harisharaju1/handheld-robotics-v1/exports/manifest.md

# Export manifest

| Part | Qty | Made by | Bounding box (mm) | Solid PETG (g, each) |
| --- | --- | --- | --- | --- |
| 00_coupon_holes | 1 | 3D print (PETG) | 100.0 x 42.0 x 6.0 | 30 |
| 00_coupon_bores | 1 | 3D print (PETG) | 130.2 x 34.0 x 8.0 | 11 |
| 10_deck_lower | 1 | laser cut 5 mm (DXF) | 250.0 x 238.1 x 5.1 | 277 |
| 11_deck_upper | 1 | laser cut 5 mm (DXF) | 250.1 x 250.0 x 5.1 | 307 |
| 22_caster_spacer | 2 | 3D print (PETG) | 36.0 x 54.0 x 42.8 | 76 |
| 30_battery_tray | 1 | 3D print (PETG) | 77.8 x 72.3 x 18.0 | 31 |
| 31_electronics_plate | 1 | 3D print (PETG) | 95.0 x 70.0 x 9.0 | 25 |
| 40_mast_base | 1 | 3D print (PETG) | 50.0 x 50.0 x 25.0 | 18 |
| 41_lidar_plate | 1 | 3D print (PETG) | 63.6 x 64.0 x 16.0 | 17 |
| 50_module_plate | 1 | 3D print (PETG) | 80.0 x 80.0 x 8.0 | 61 |

Printed total if solid: 346 g. At 40% infill / 3 walls expect roughly 190 g.
