harisharaju1/handheld-robotics-v1/docs/templates/deck_templates_A3.pdf

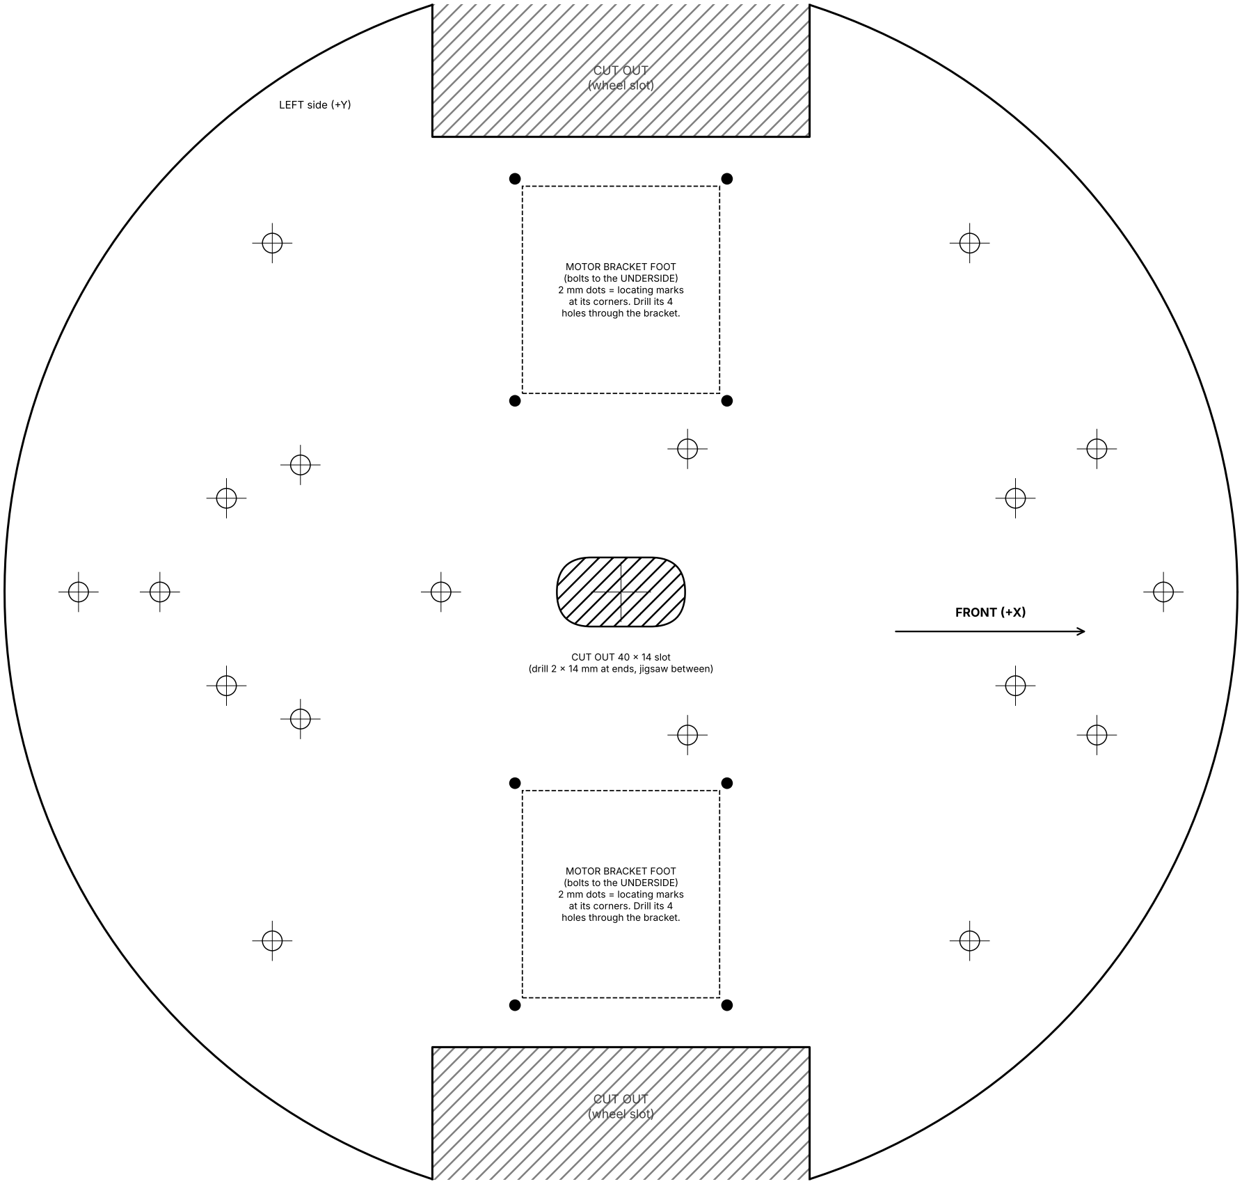
[picture p2: figure]
CUT OUT (wheel slot); CUT OUT 40 x 14 slot; MOTOR BRACKET FOOT (bolts to the UNDERSIDE); 2 mm dots = locating marks at its corners. Drill its 4 holes through the bracket.; FRONT (+X); LEFT side (+Y)

(drill 2 x 14 mm at ends, jigsaw between)

# LOWER DECK - 1:1 TEMPLATE (handheld-robotics-v1, Nov 2026, direct-mount)

Print at 100% / 'Actual size' - NOT 'fit to page'. Check the 100 mm bar first.
26 holes: centre-punch each crosshair, drill 3 mm pilot, then open to 4 mm (black dots: 2 mm). Scrap wood behind. Outer line = cut line (250 mm circle). Hatched = remove. Top face up; deck is symmetric left-right.

100 mm - measure this

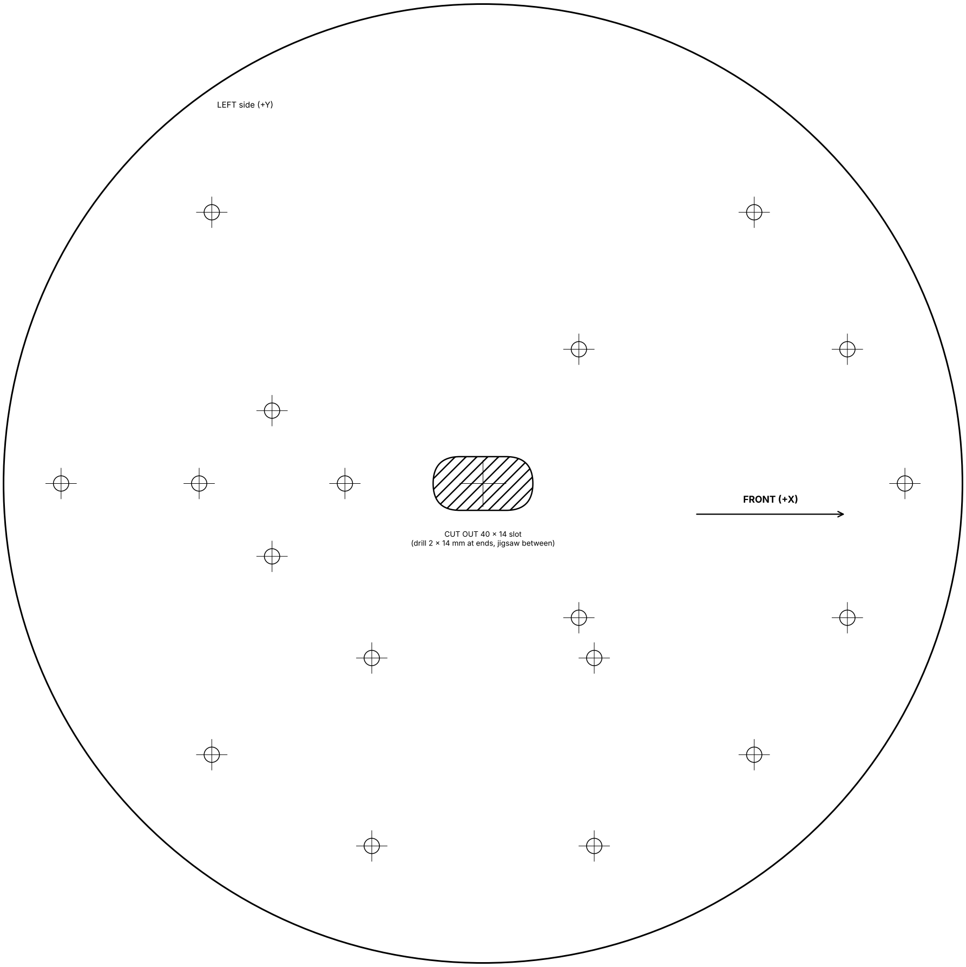
[picture p3: figure]
CUT OUT 40 x 14 slot; FRONT (+X); LEFT side (+Y)

(drill 2 x 14 mm at ends, jigsaw between)

# UPPER DECK - 1:1 TEMPLATE (handheld-robotics-v1, Nov 2026, direct-mount)

Print at 100% / 'Actual size' - NOT 'fit to page'. Check the 100 mm bar first.
18 holes: centre-punch each crosshair, drill 3 mm pilot, then open to 4 mm (black dots: 2 mm). Scrap wood behind. Outer line = cut line (250 mm circle). Hatched = remove. Top face up; deck is symmetric left-right.

100 mm - measure this
