harisharaju1/handheld-robotics-v1/docs/concept_b_fetcher_gripper_close_up_labeled.png

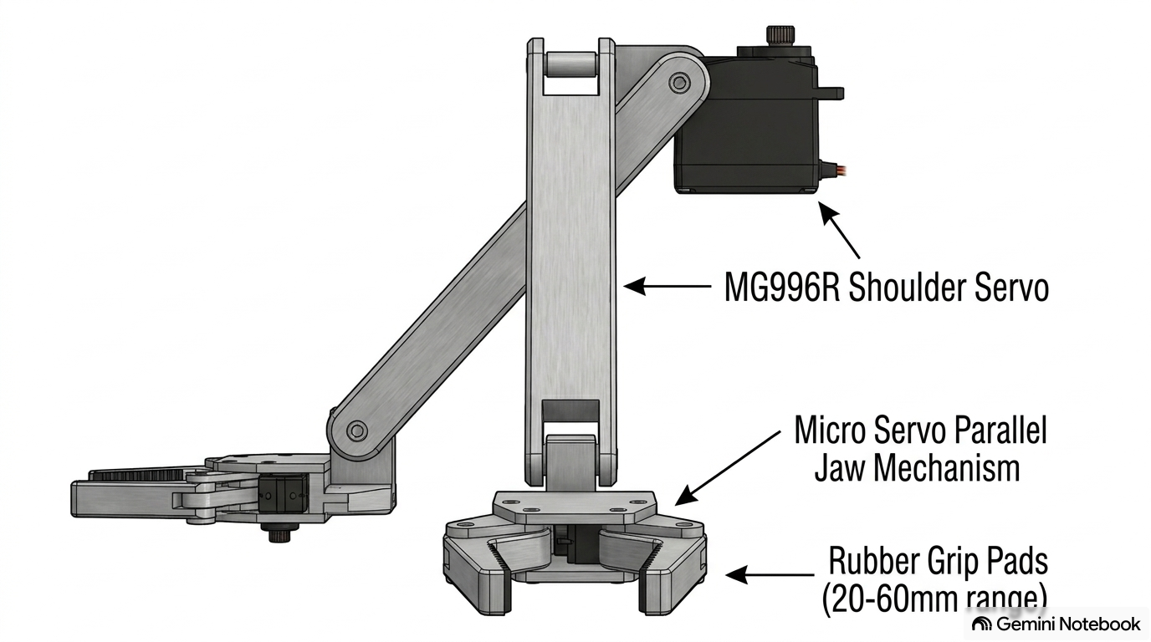
docs/concept_b_fetcher_gripper_close_up_labeled.png
