harisharaju1/handheld-robotics-v1/docs/concept_b_fetcher_robot.png

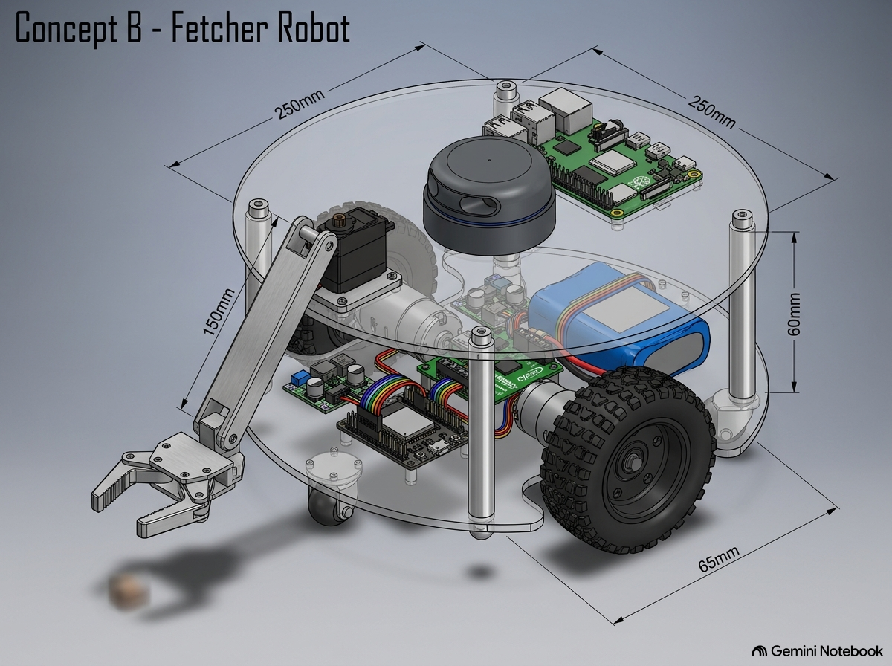
docs/concept_b_fetcher_robot.png
