harisharaju1/handheld-robotics-v1/docs/concept_b_fetcher_side_view_labeled.png

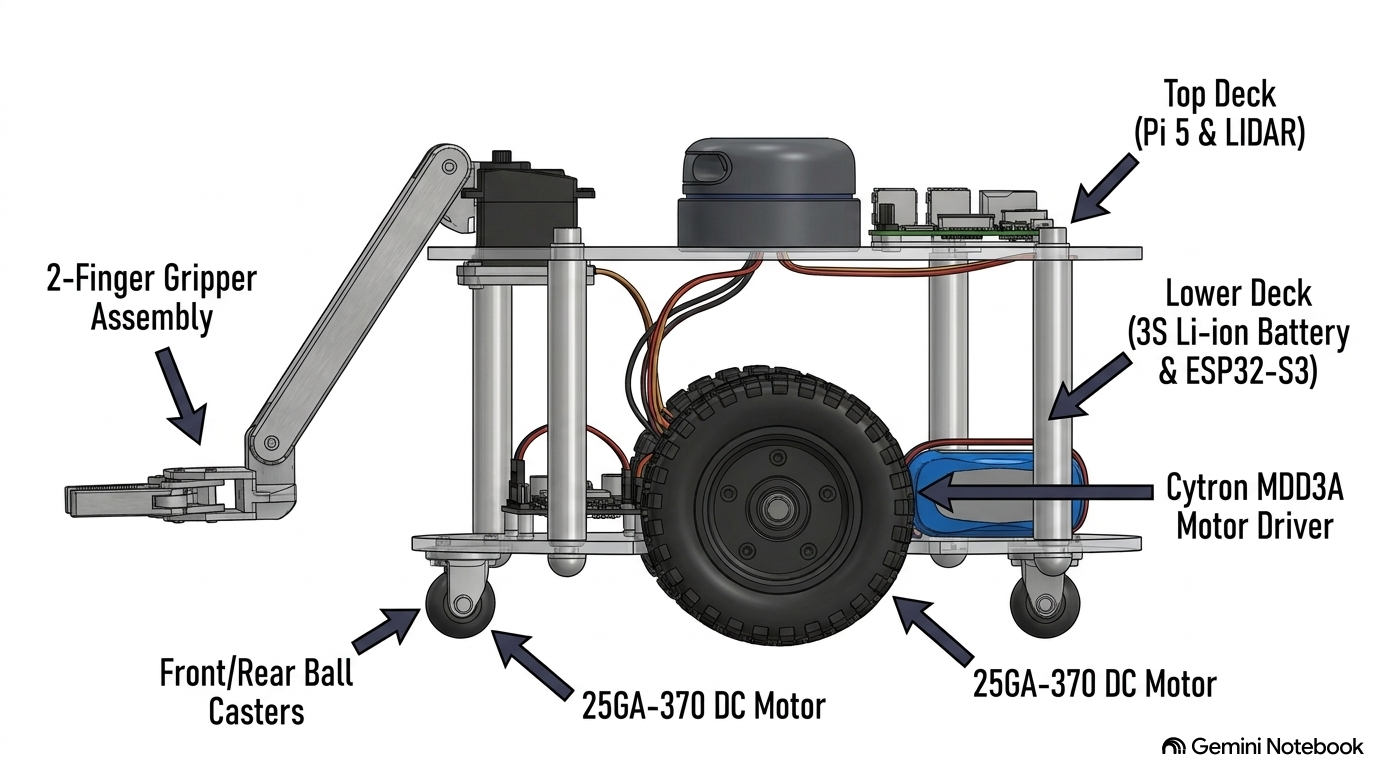
docs/concept_b_fetcher_side_view_labeled.png
