harisharaju1/handheld-robotics-v1/docs/concept_b_fetcher_top_view_labeled.png

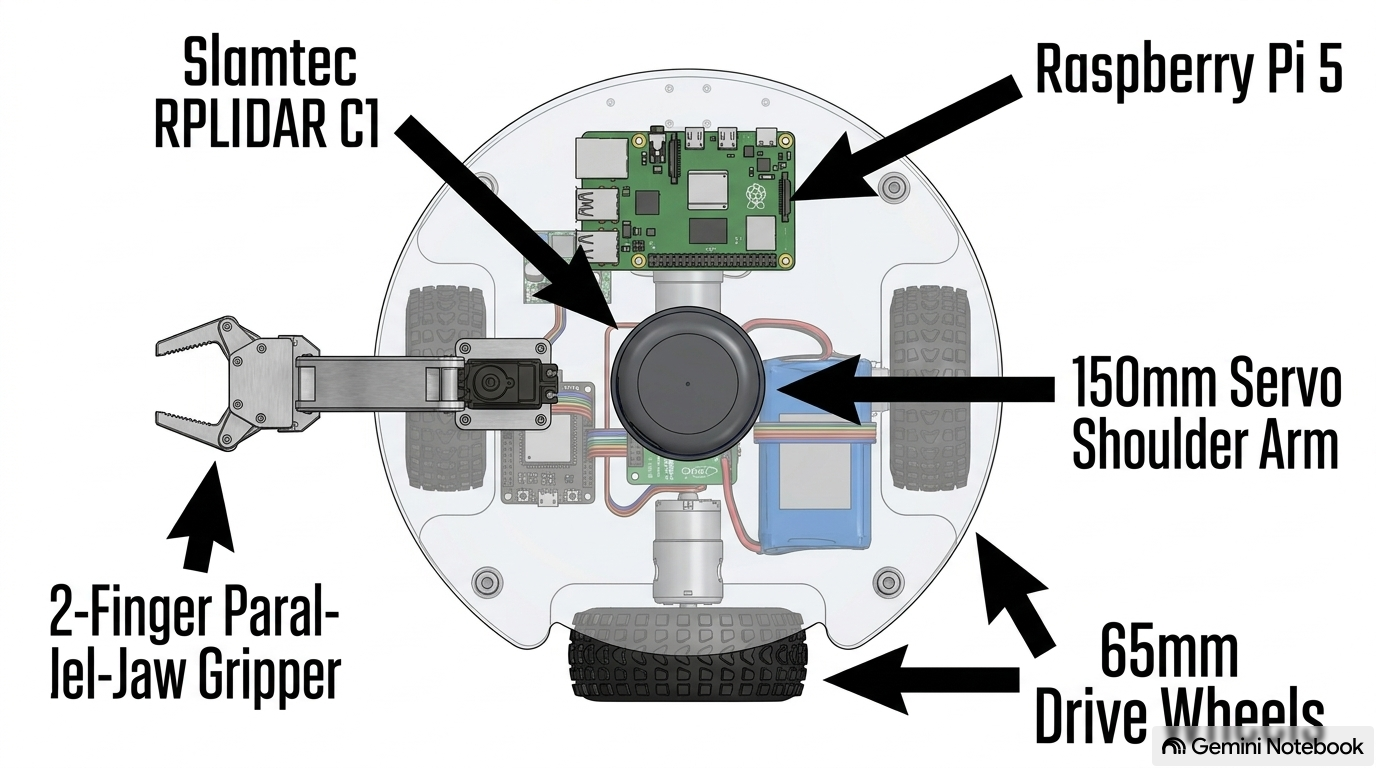
docs/concept_b_fetcher_top_view_labeled.png
