harisharaju1/handheld-robotics-v1/docs/layout/layout_fetcher_preview.png

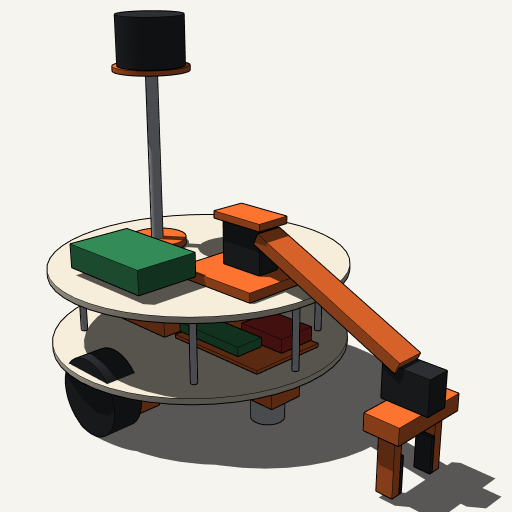
docs/layout/layout_fetcher_preview.png
