harisharaju1/handheld-robotics-v1/exports/step/99_base_assembly.step

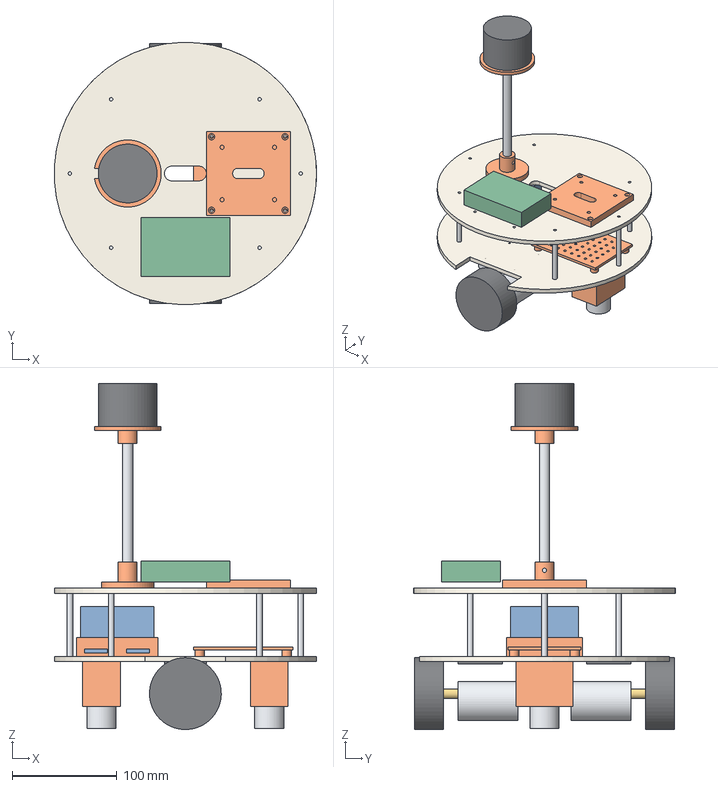
[picture p9: CAD file, 2026-11-06]
exports/step/99_base_assembly.step
249.8 x 249.9 x 329.7 mm
deck_lower
deck_upper
standoff_0
standoff_1
standoff_2
standoff_3
standoff_4
standoff_5
bracket_foot_left
motor_left
hub_left
wheel_left
bracket_foot_right
motor_right
hub_right
wheel_right
caster_spacer_front x 2
caster_front
caster_rear
battery_tray
battery_3s
electronics_plate
mast_base
mast_tube
lidar_plate
rplidar_c1
module_plate
raspberry_pi_5
