harisharaju1/handheld-robotics-v1/exports/step/11_deck_upper.step

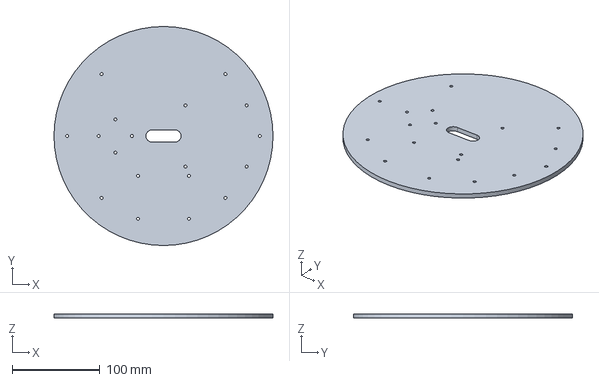
[picture p10: CAD file, 2026-11-06]
exports/step/11_deck_upper.step
250.0 x 250.0 x 5.00 mm
