harisharaju1/handheld-robotics-v1/exports/step/00_coupon_bores.step

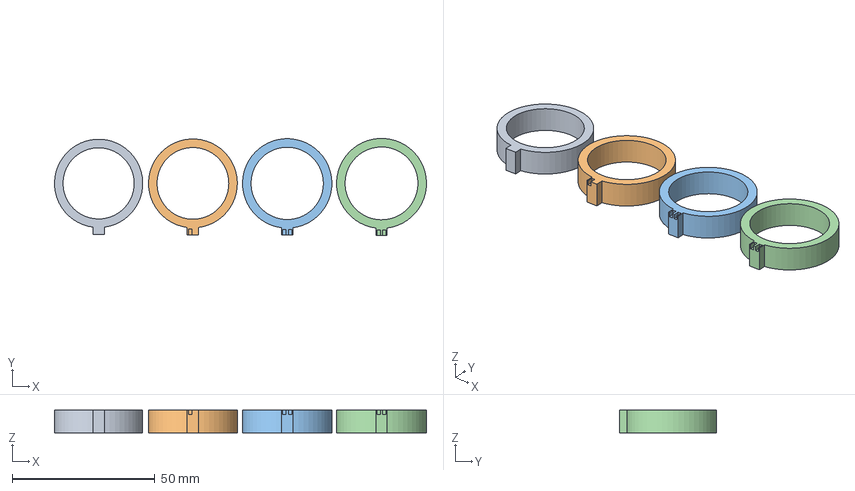
[picture p11: CAD file, 2026-11-06]
exports/step/00_coupon_bores.step
130.2 x 34.0 x 8.00 mm
