harisharaju1/handheld-robotics-v1/exports/step/40_mast_base.step

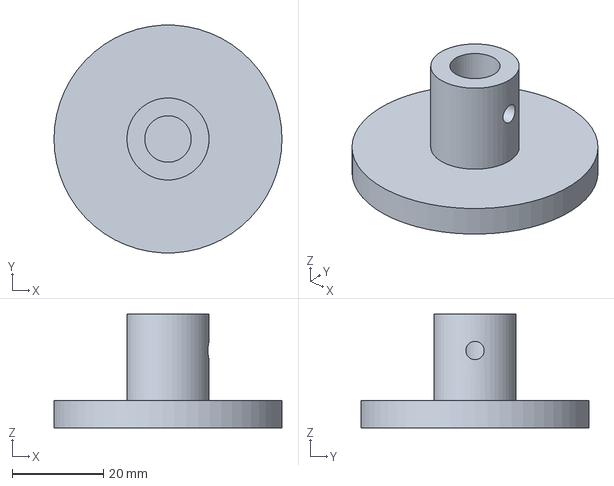
[picture p12: CAD file, 2026-11-06]
exports/step/40_mast_base.step
50.0 x 49.9 x 25.0 mm
