harisharaju1/handheld-robotics-v1/exports/step/41_lidar_plate.step

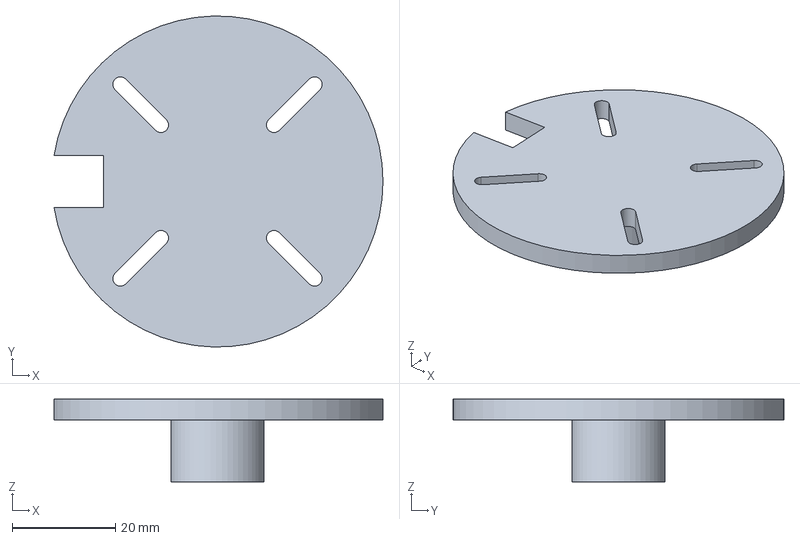
[picture p13: CAD file, 2026-11-06]
exports/step/41_lidar_plate.step
63.6 x 64.0 x 16.0 mm
