harisharaju1/handheld-robotics-v1/exports/step/31_electronics_plate.step

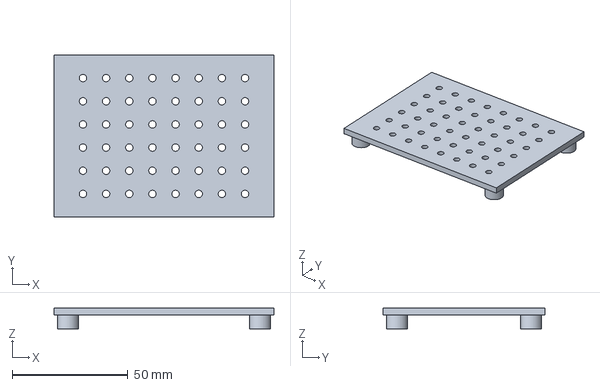
[picture p14: CAD file, 2026-11-06]
exports/step/31_electronics_plate.step
95.0 x 70.0 x 9.00 mm
