harisharaju1/handheld-robotics-v1/exports/step/22_caster_spacer.step

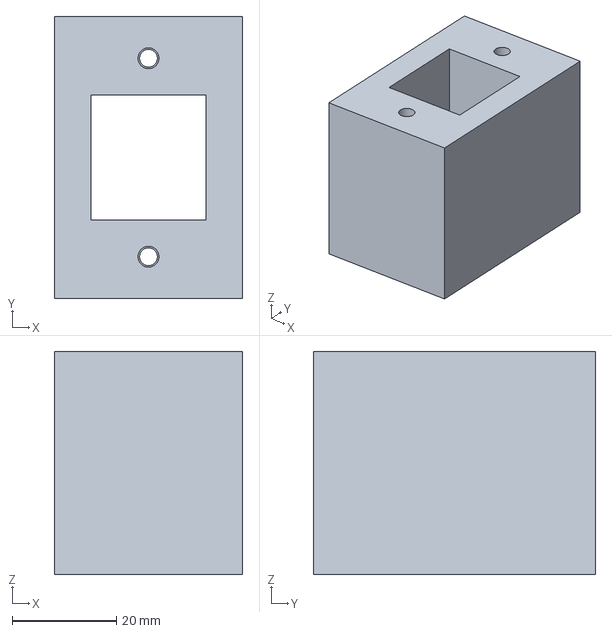
[picture p15: CAD file, 2026-11-06]
exports/step/22_caster_spacer.step
36.0 x 54.0 x 42.8 mm
