harisharaju1/handheld-robotics-v1/exports/step/30_battery_tray.step

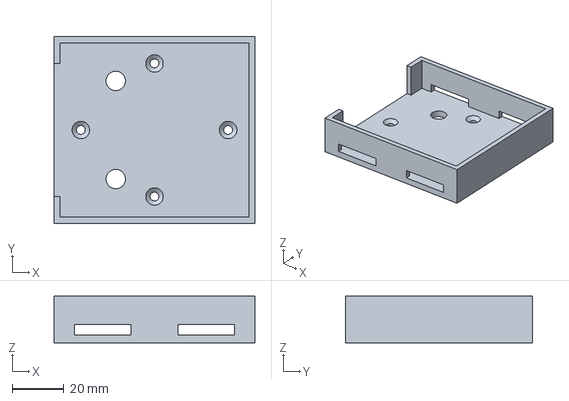
[picture p16: CAD file, 2026-11-06]
exports/step/30_battery_tray.step
77.8 x 72.3 x 18.0 mm
