harisharaju1/handheld-robotics-v1/exports/step/00_coupon_holes.step

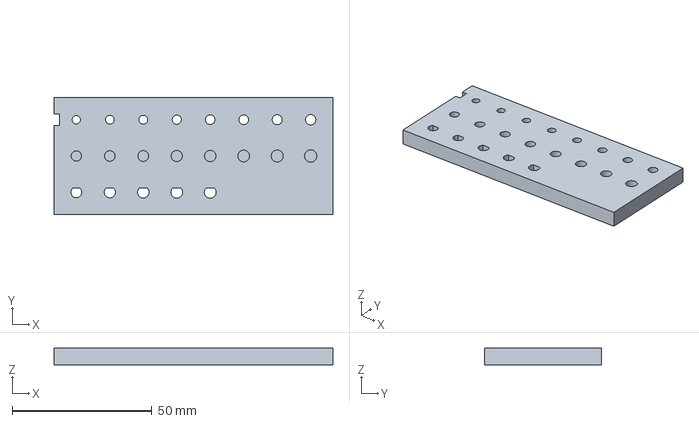
[picture p17: CAD file, 2026-11-06]
exports/step/00_coupon_holes.step
100.0 x 42.0 x 6.00 mm
