harisharaju1/handheld-robotics-v1/exports/step/50_module_plate.step

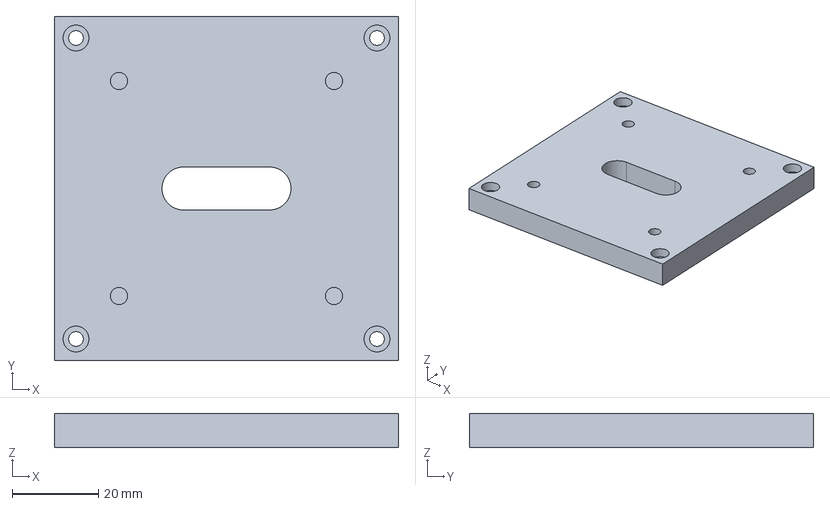
[picture p18: CAD file, 2026-11-06]
exports/step/50_module_plate.step
80.0 x 80.0 x 8.00 mm
