harisharaju1/handheld-robotics-v1/exports/step/10_deck_lower.step

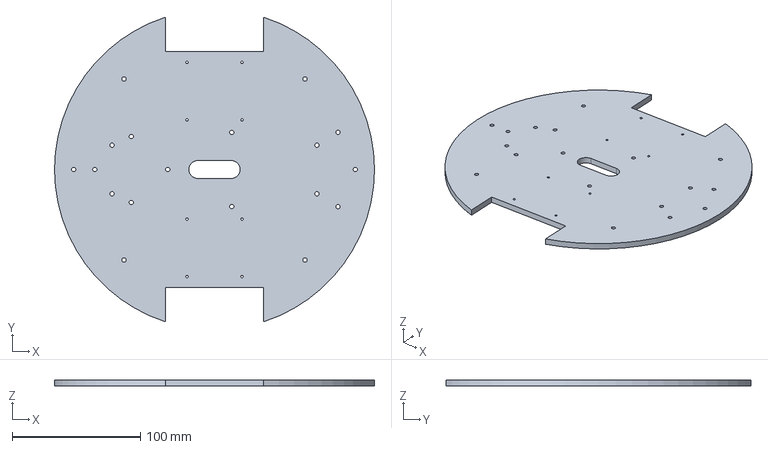
[picture p19: CAD file, 2026-11-06]
exports/step/10_deck_lower.step
250.0 x 238.0 x 5.00 mm
