harisharaju1/handheld-robotics-v1/exports/step/20_motor_adapter.step

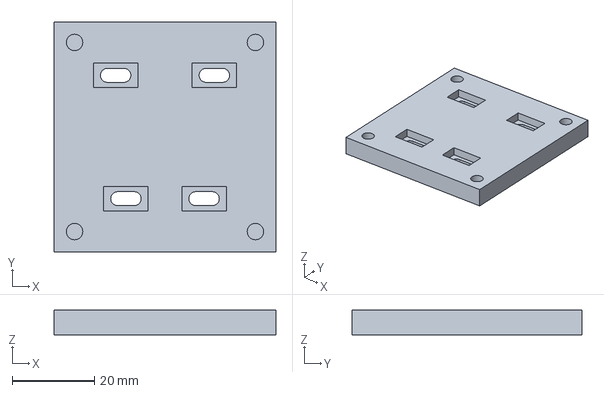
[picture p20: CAD file, 2026-11-03]
exports/step/20_motor_adapter.step
54.0 x 56.0 x 6.00 mm
