harisharaju1/handheld-robotics-v1/exports/step/20_motor_clamp_saddle.step

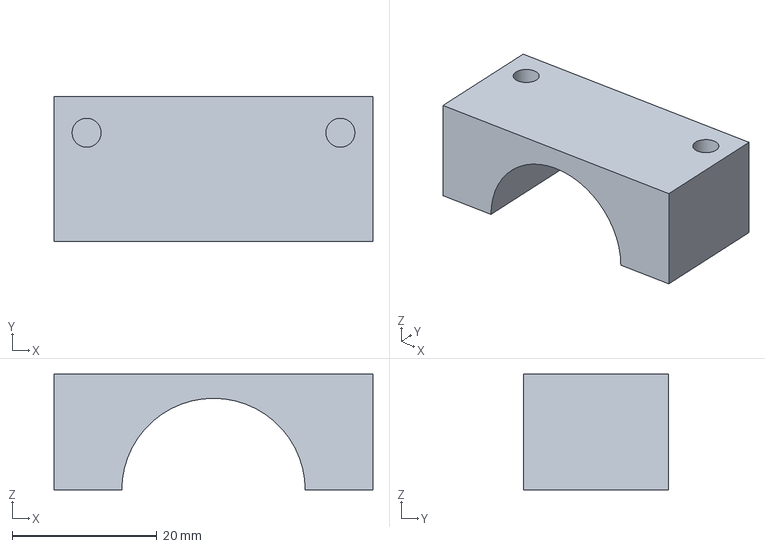
[picture p21: CAD file, 2026-10-08]
exports/step/20_motor_clamp_saddle.step
44.0 x 20.0 x 16.0 mm
