harisharaju1/handheld-robotics-v1/exports/step/21_motor_clamp_cap.step

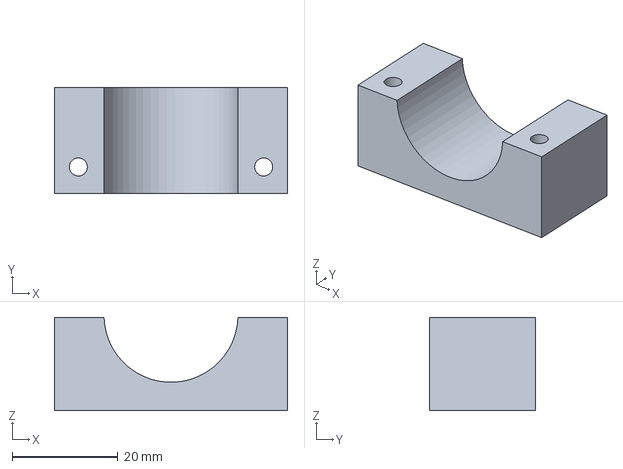
[picture p22: CAD file, 2026-10-08]
exports/step/21_motor_clamp_cap.step
44.0 x 20.0 x 17.6 mm
