harisharaju1/handheld-robotics-v1/(list of files, cad)

Other CAD files:
docs/handheld-robotics-v1_layout.skp
exports/_obsolete/20_motor_adapter.stl
exports/_obsolete/20_motor_clamp_saddle.stl
exports/_obsolete/21_motor_clamp_cap.stl
exports/dxf/10_deck_lower.dxf
exports/dxf/11_deck_upper.dxf
exports/stl/00_coupon_bores.stl
exports/stl/00_coupon_holes.stl
exports/stl/10_deck_lower.stl
exports/stl/11_deck_upper.stl
exports/stl/20_motor_adapter.stl
exports/stl/20_motor_clamp_saddle.stl
exports/stl/21_motor_clamp_cap.stl
exports/stl/22_caster_spacer.stl
exports/stl/30_battery_tray.stl
exports/stl/31_electronics_plate.stl
exports/stl/40_mast_base.stl
exports/stl/41_lidar_plate.stl
exports/stl/50_module_plate.stl
