harisharaju1/handheld-robotics-v1/docs/templates/deck_templates_A4_tiled.pdf

# LOWER DECK - 1:1 TEMPLATE (handheld-robotics-v1, Nov 2026, direct-mount)

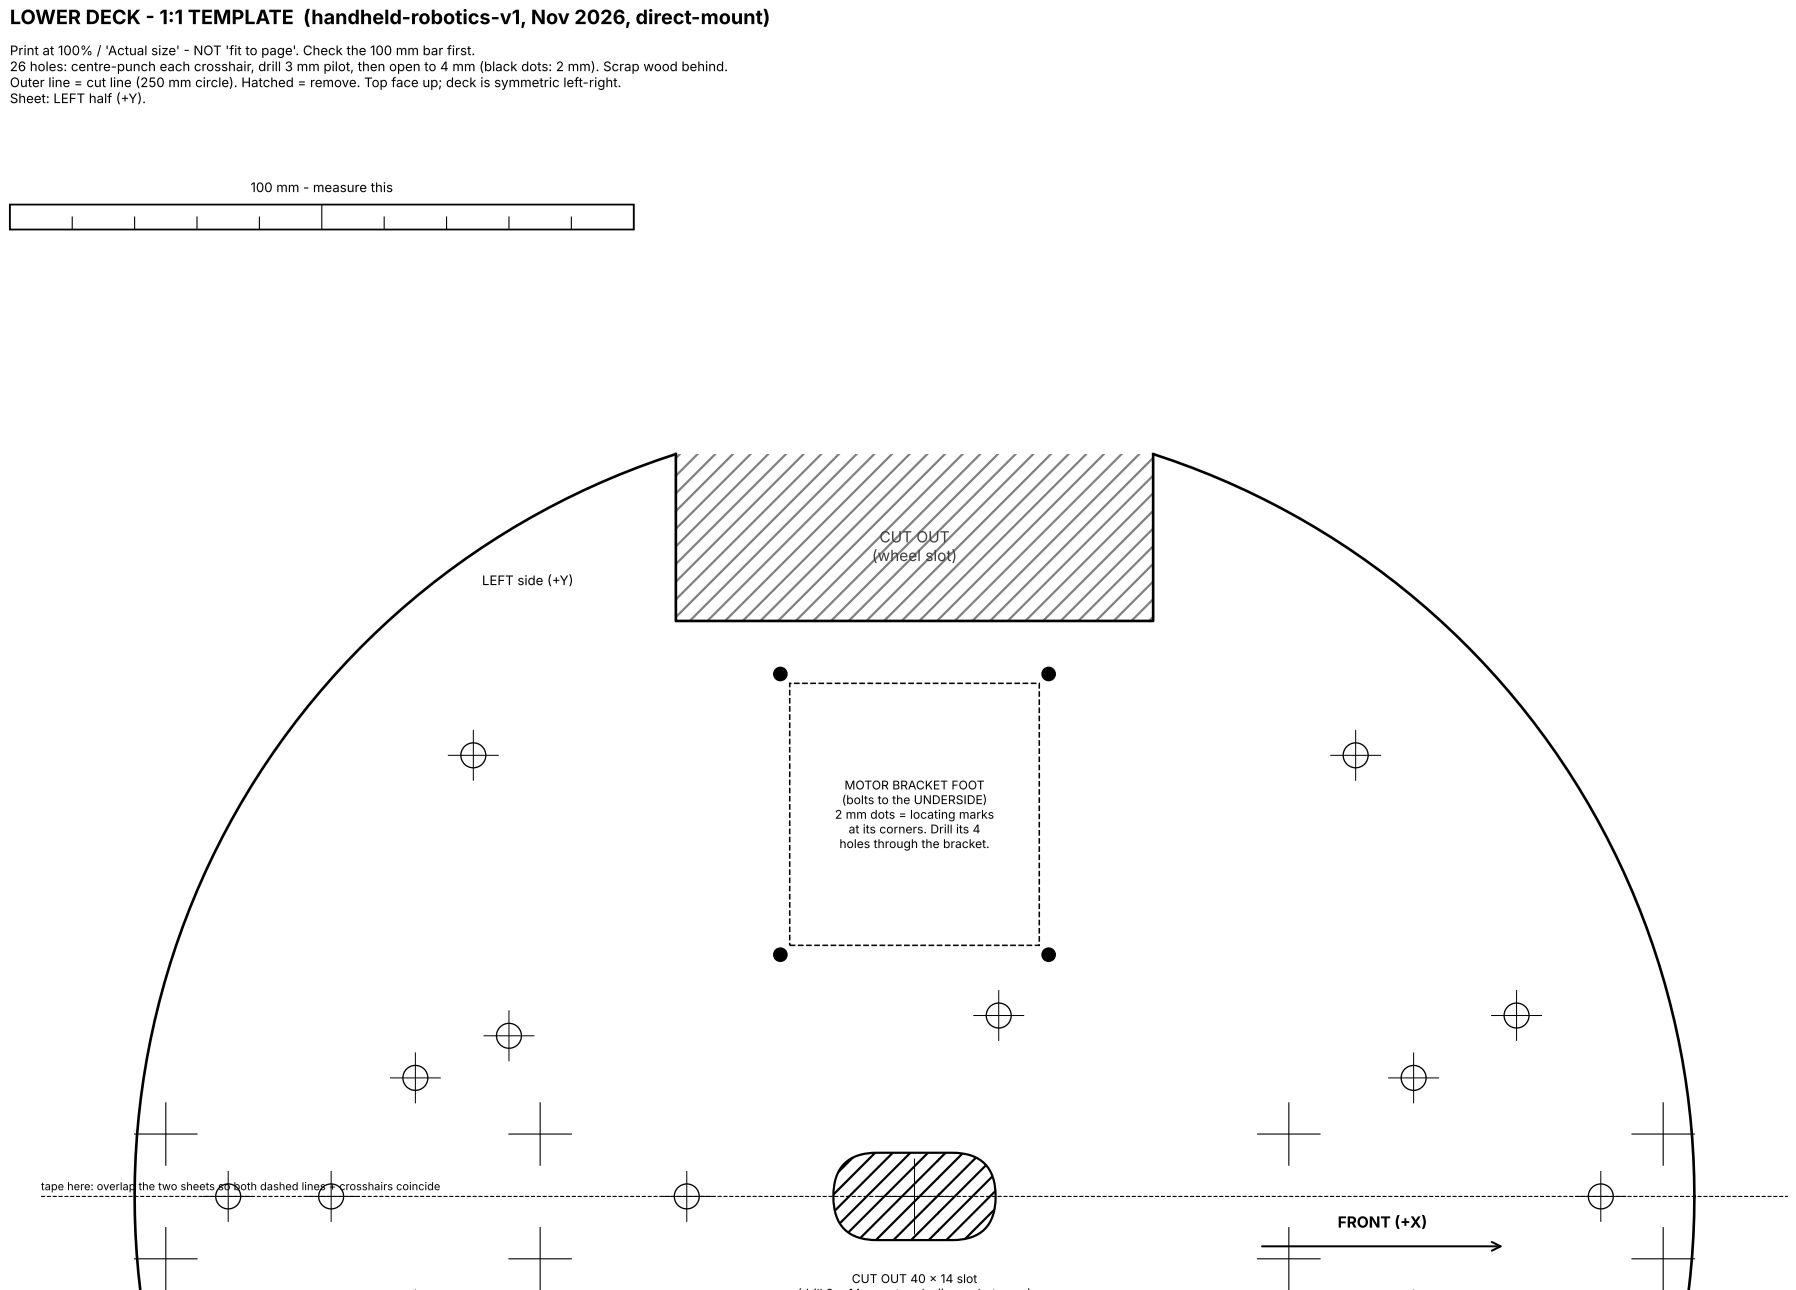
[picture p23: page 1]
CUT OUT (wheel slot); FRONT (+X); LEFT side (+Y)

Print at 100% / 'Actual size' - NOT 'fit to page'. Check the 100 mm bar first.
26 holes: centre-punch each crosshair, drill 3 mm pilot, then open to 4 mm (black dots: 2 mm). Scrap wood behind.
Outer line = cut line (250 mm circle). Hatched = remove. Top face up; deck is symmetric left-right.
Sheet: LEFT half (+Y).

100 mm - measure this

MOTOR BRACKET FOOT
(bolts to the UNDERSIDE)
2 mm dots = locating marks
at its corners. Drill its 4
holes through the bracket.

tape here: overlap the two sheets so both dashed lines + crosshairs coincide

(drill 2 x 14 mm at ends, jigsaw between)

CUT OUT 40 x 14 slot

## FRONT (+X)

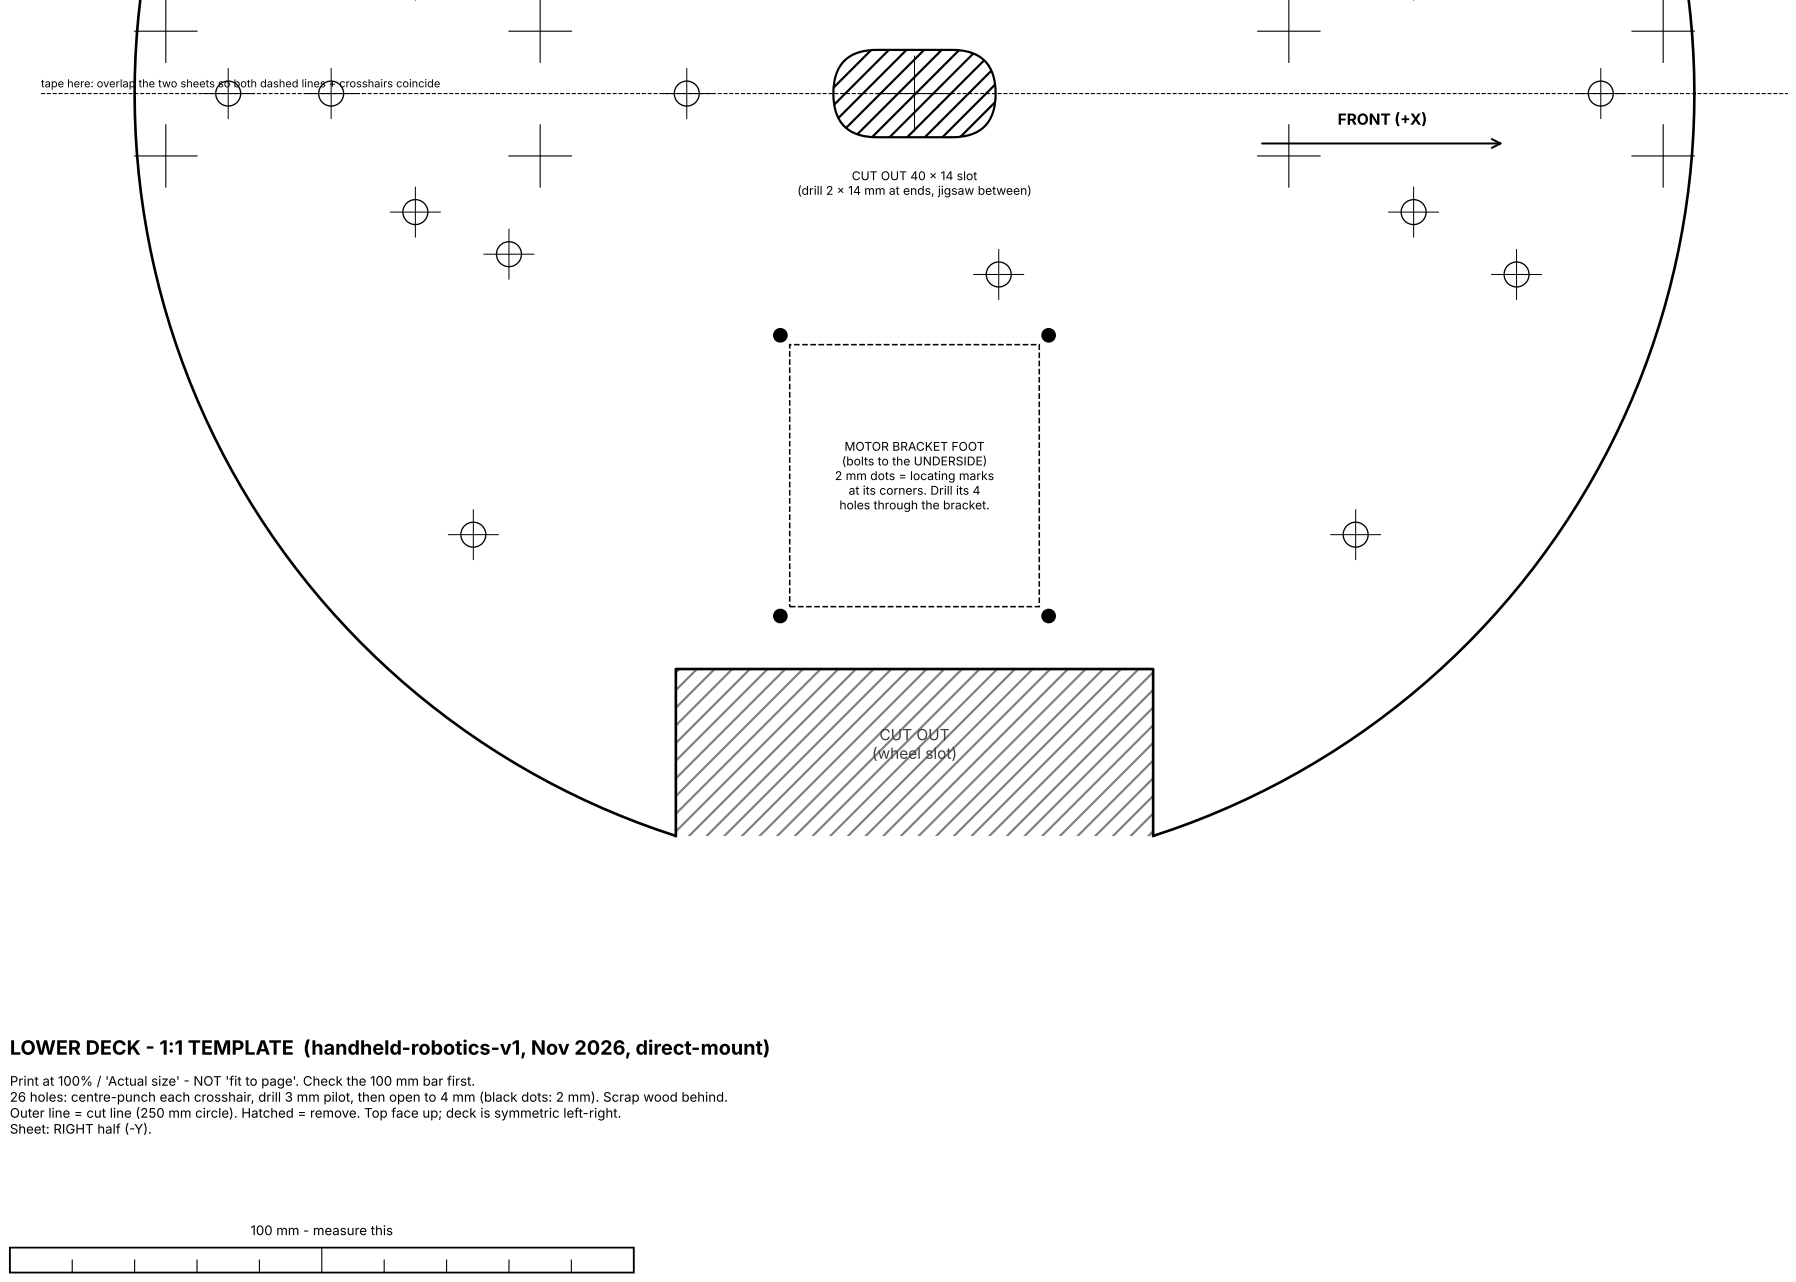
[picture p24: page 2]
CUT OUT (wheel slot)

CUT OUT 40 x 14 slot

(drill 2 x 14 mm at ends, jigsaw between)

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

LOWER DECK - 1:1 TEMPLATE (handheld-robotics-v1, Nov 2026, direct-mount)

Print at 100% / 'Actual size' - NOT 'fit to page'. Check the 100 mm bar first.
26 holes: centre-punch each crosshair, drill 3 mm pilot, then open to 4 mm (black dots: 2 mm). Scrap wood behind.
Outer line = cut line (250 mm circle). Hatched = remove. Top face up; deck is symmetric left-right.
Sheet: RIGHT half (-Y).

100 mm - measure this

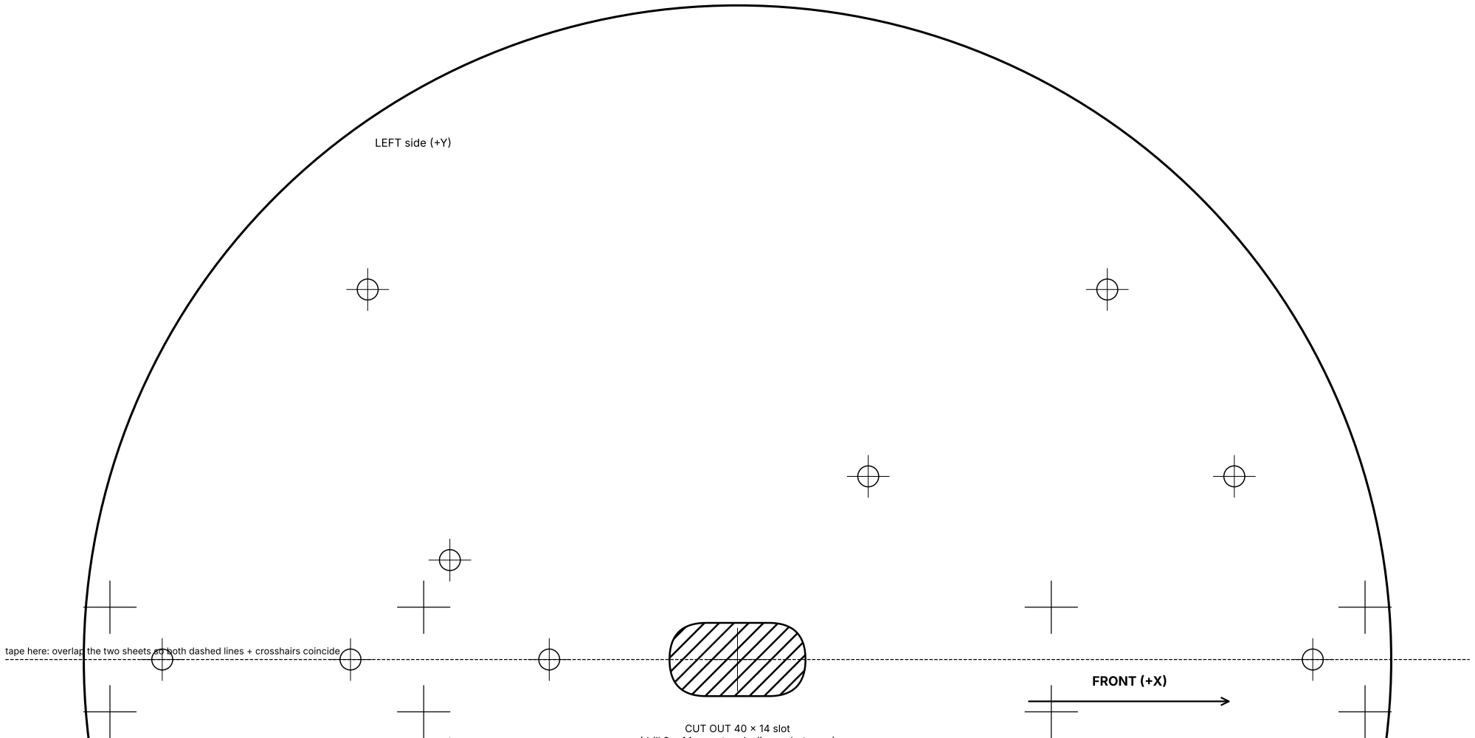
[picture p25: figure]
CUT OUT 40 x 14 slot; FRONT (+X); LEFT side (+Y)

(drill 2 x 14 mm at ends, jigsaw between)

# UPPER DECK - 1:1 TEMPLATE (handheld-robotics-v1, Nov 2026, direct-mount)

Print at 100% / 'Actual size' - NOT 'fit to page'. Check the 100 mm bar first.
18 holes: centre-punch each crosshair, drill 3 mm pilot, then open to 4 mm (black dots: 2 mm). Scrap wood behind. Outer line = cut line (250 mm circle). Hatched = remove. Top face up; deck is symmetric left-right.
Sheet: LEFT half (+Y).

100 mm - measure this

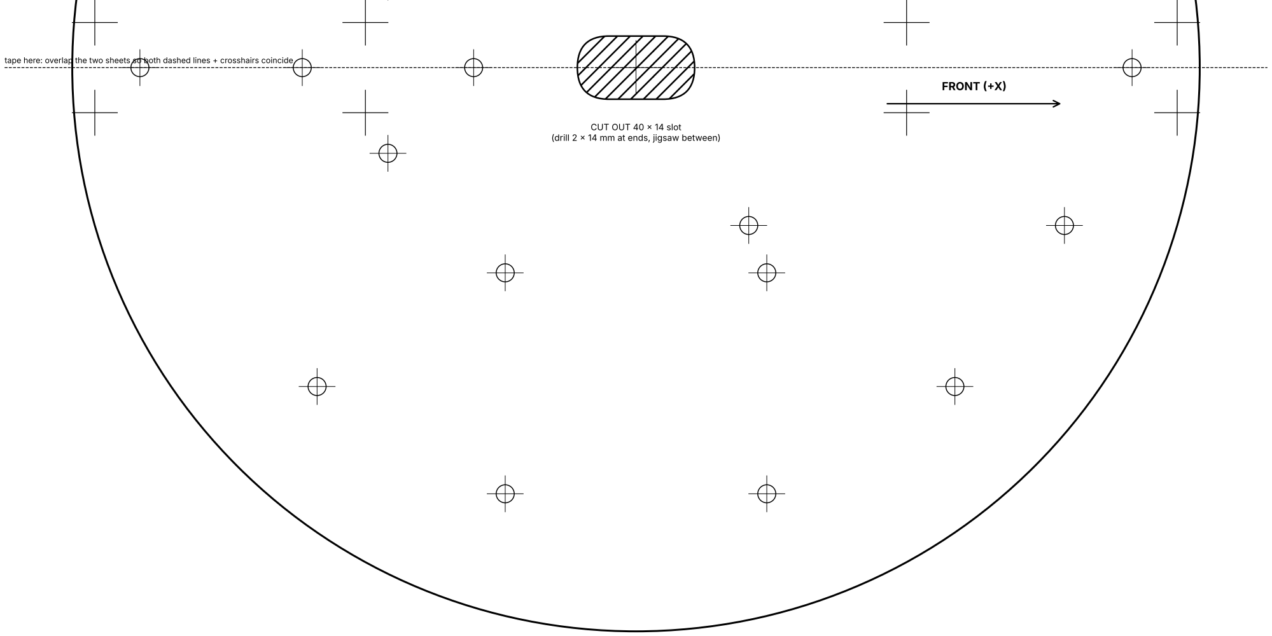
[picture p26: figure]
CUT OUT 40 x 14 slot; FRONT (+X)

(drill 2 x 14 mm at ends, jigsaw between)

# UPPER DECK - 1:1 TEMPLATE (handheld-robotics-v1, Nov 2026, direct-mount)

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

100 mm - measure this
